bootsector/wii-retropad-adapter/board/board.png

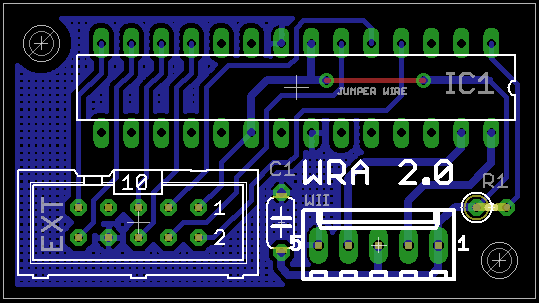
board/board.png
