bootsector/wii-retropad-adapter/board/board_v21.png

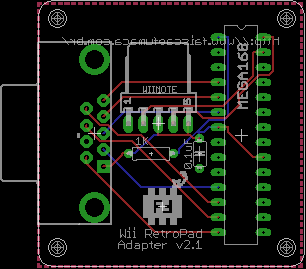
board/board_v21.png
