bootsector/wii-retropad-adapter/board/schematics_v20.png

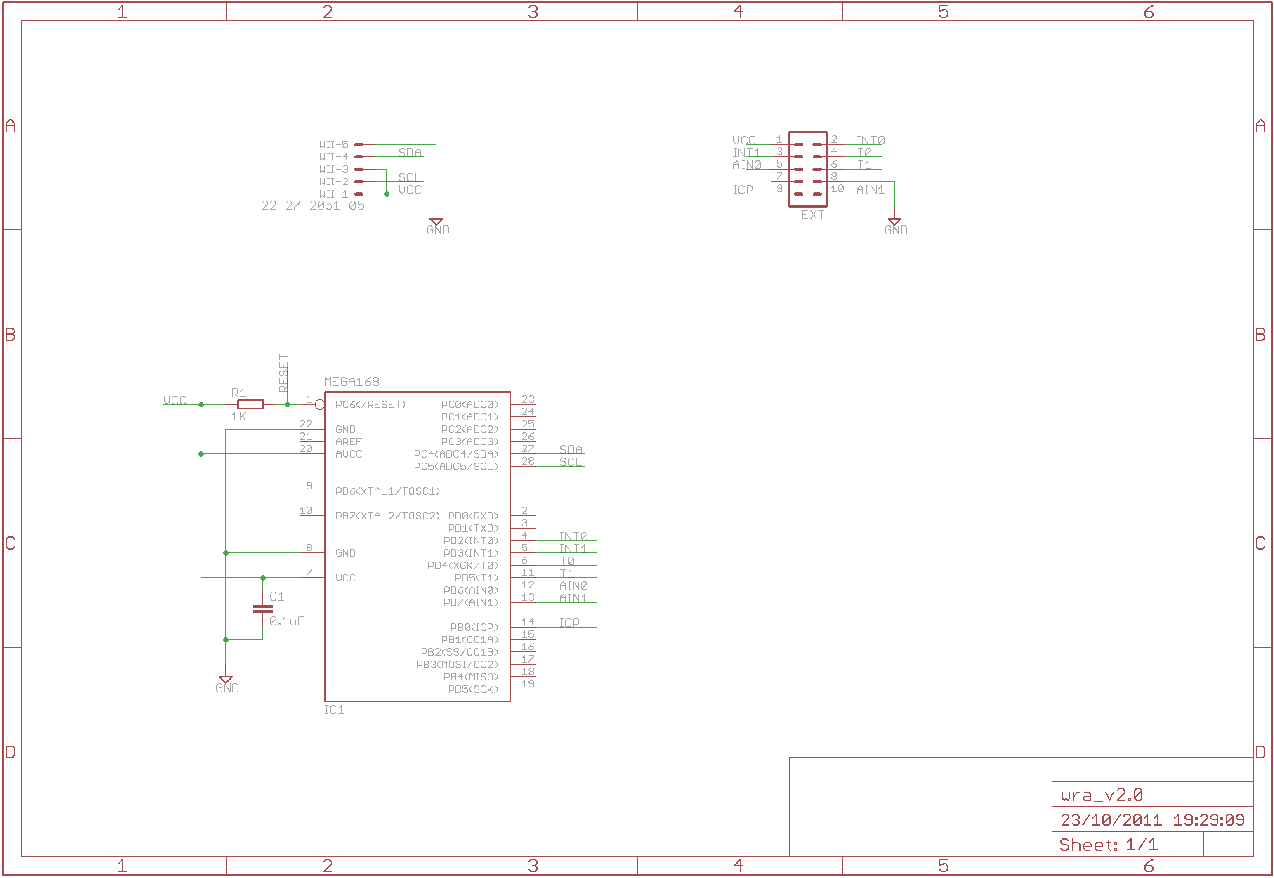
board/schematics_v20.png
