bootsector/wii-retropad-adapter/board/schematics_v21.png

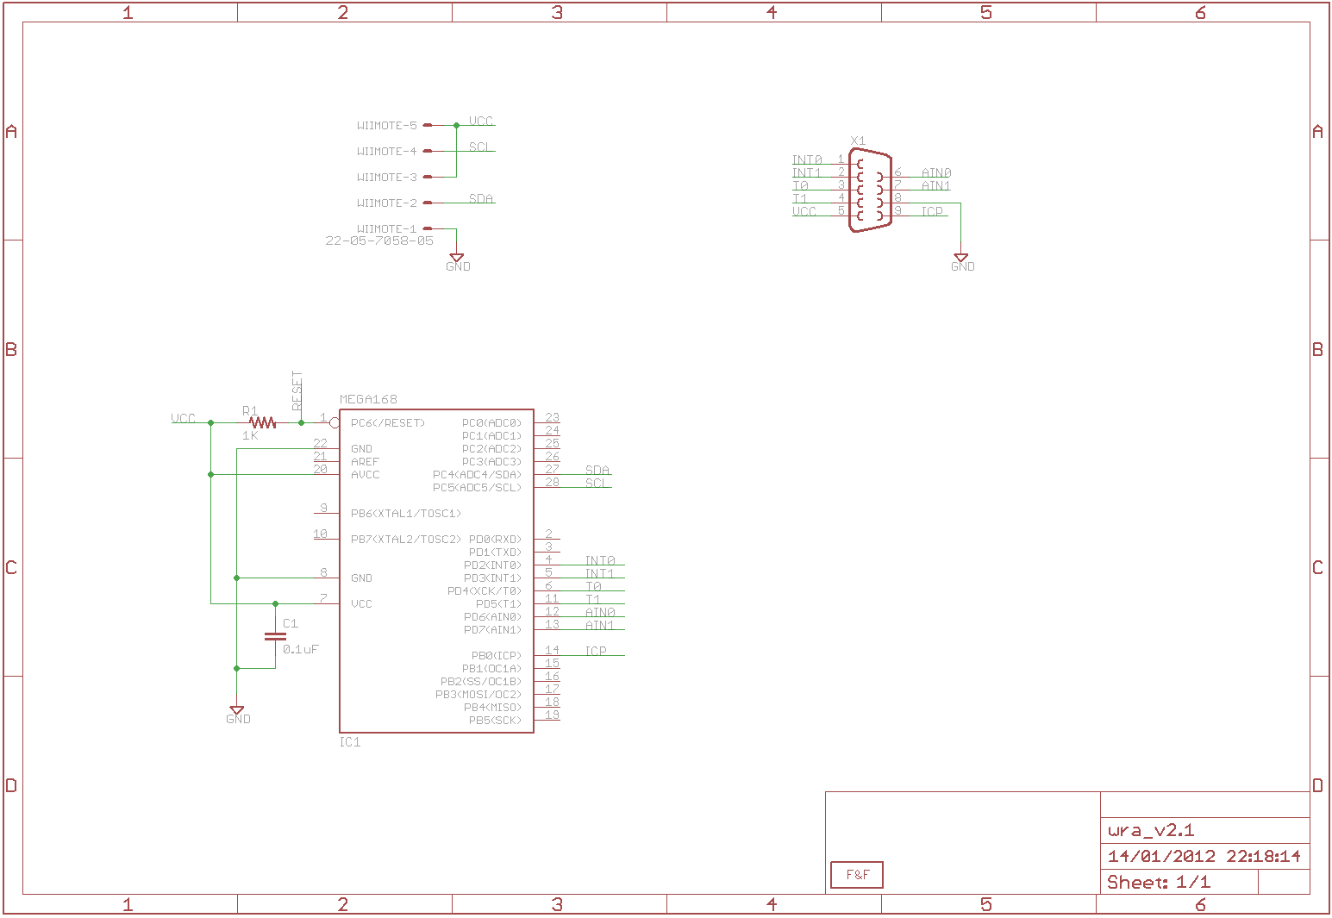
board/schematics_v21.png
