bootsector/wii-retropad-adapter/WiiRetroPadAdapterUserManual_ptBR.pdf

### Wii RetroPad Adapter 2.0 – Manual do Usuário

Rev. 2.1 – 10/03/2012

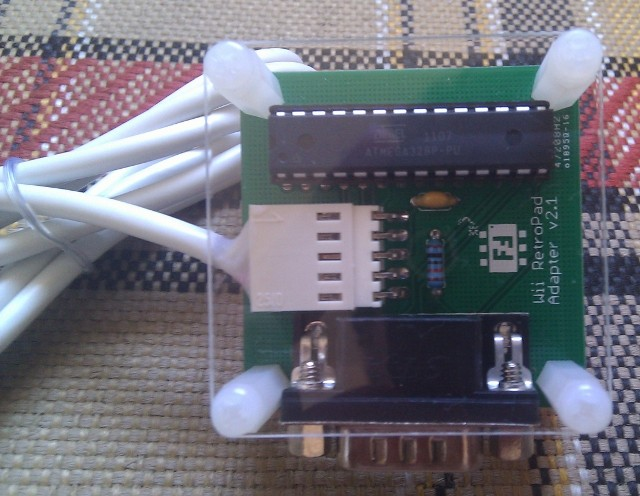
[picture p5: figure]

Conectando o adaptador ao Wiimote

- Desconecte o Wii RetroPad Adapter do Wiimote antes de conectar qualquer joystick ou cabo de expansão ao Wii

RetroPad Adapter;

- Se você for usar um joystick de Sega Genesis, Master System ou Atari 2600, conecte-o diretamente ao Wii

RetroPad Adapter, ou...

- Se você for usar qualquer outro joystick compatível com o Wii RetroPad Adapter, primeiramente conecte o cabo de

expansão (vendido separadamente) ao Wii RetroPad Adapter e então conecte o joystick ao conector do cabo de

expansão;

- Conecte o Wii RetroPad Adapter no Wiimote. Ele será reconhecido como um Classic Controller;
- Divirta-se!

Mapa de botões:

Joystick “Retrô” | Botão correspondente no Wii Classic Controller
D-Pad | Y | B | X | A | + | - | HOME | Left Analog | Right Analog | L | R | ZL | ZR
NES | D-Pad | - | B | - | A | START | SELECT | SEL.+START | - | - | - | - | - | -
Super NES | D-Pad | Y | B | X | A | START | SELECT | SEL.+START | - | - | L | R | - | -
Sega Genesis | D-Pad | A | B | Y | C | START | MODE | UP+START | - | - | X | Z | - | -
PS2 | D-Pad | [ ] | X | /\ | O | START | SELECT | SEL.+START | Left Analog | Right Analog | L1 | R1 | L2 | R2
Game Cube | D-Pad | Y | B | X | A | START | - | UP+START | Left Analog | Right Analog | L | R | Z | Z
Nintendo 64 | D-Pad | CL | B | CR | A | START | - | UP+START | Left Analog | C Buttons | L* | R | Z* | Z*

* - L e Z serão invertidos se um controle de N64 for plugado com o botão L pressionado (essa é a melhor opção para Jogos de Zelda do Nintendo 64 no Virtual Console).

Outras informações:

- Vibração do joystick não é suportado.
- Apenas Wiimotes originais são suportados e têm funcionamento garantido com esse adaptador.
- Apensar de alguns controles genéricos de PS2, Game Cube e Nintendo 64 funcionarem com esse adaptador,

apenas controles originais possuem garantia de funcionamento com esse adaptador.

- Para maiores informações, acesse: http://www.brunofreitas.com/ .
