bootsector/wii-retropad-adapter/src/wii-retropad-adapter/tg16.cpp

/*
* Wii RetroPad Adapter - Nintendo Wiimote adapter for retro-controllers!
* Copyright (c) 2011 Bruno Freitas - bruno@brunofreitas.com
*
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
* You should have received a copy of the GNU General Public License
* along with this program.  If not, see <http://www.gnu.org/licenses/>.
 */

#include "tg16.h"
#include "digitalWriteFast.h"

void tg16_init(void) {
	// Configure Data pins
	pinModeFast(2, INPUT);
	digitalWriteFast(2, HIGH);

	pinModeFast(4, INPUT);
	digitalWriteFast(4, HIGH);

	pinModeFast(5, INPUT);
	digitalWriteFast(5, HIGH);

	pinModeFast(6, INPUT);
	digitalWriteFast(6, HIGH);

	// Configure Data Select and /OE pins
	pinModeFast(7, OUTPUT);
	digitalWriteFast(7, HIGH);

	pinModeFast(8, OUTPUT);
	digitalWriteFast(8, LOW);
}

int tg16_read(void) {
	int retval = 0;

	// Data Select HIGH
	digitalWriteFast(7, HIGH);

	// /OE LOW
	digitalWriteFast(8, LOW);

	for(int i = 0; i < 2; i++) {
		// /OE LOW
		digitalWriteFast(8, LOW);
		delayMicroseconds(1);

		// If four directions are low, then it's an Avenue6 Pad
		if(!digitalReadFast(2) && !digitalReadFast(4) && !digitalReadFast(5) && !digitalReadFast(6)) {
			// Data Select LOW
			digitalWriteFast(7, LOW);
			delayMicroseconds(1);

			retval |= (!digitalReadFast(2) << 8);  // III
			retval |= (!digitalReadFast(4) << 9);  // IV
			retval |= (!digitalReadFast(5) << 10); // V
			retval |= (!digitalReadFast(6) << 11); // VI
		} else {
			// Normal pad reading
			retval |= (!digitalReadFast(2) << 0); // UP
			retval |= (!digitalReadFast(4) << 1); // RIGHT
			retval |= (!digitalReadFast(5) << 2); // DOWN
			retval |= (!digitalReadFast(6) << 3); // LEFT

			// Data Select LOW
			digitalWriteFast(7, LOW);
			delayMicroseconds(1);

			retval |= (!digitalReadFast(2) << 4); // I
			retval |= (!digitalReadFast(4) << 5); // II
			retval |= (!digitalReadFast(5) << 6); // SELECT
			retval |= (!digitalReadFast(6) << 7); // RUN
		}

		// Data Select HIGH
		digitalWriteFast(7, HIGH);

		// /OE HIGH
		digitalWriteFast(8, HIGH);
	}

	return retval;
}
