bootsector/wii-retropad-adapter/(commit log)

2011-09-20 Modified Makefile.app so it now supports programming properly. Assuming there's no Arduino bootloader on the uC (i.e., a blank atmega328p).
2011-09-25 Updated Arduino sketch. Removed old binaries folder.
2011-09-25 Updated arduinocore sources with actual arduino-22 sources.
2011-09-26 Support to WMExtension's callback for buttons update is now optional at compile time.
2011-09-27 Joystick responsiveness seems slightly improved if not using buttons update callback. Leaving it deactivated by default.
2011-09-30 Externalized compile time settings to config.h file. Home button can now be triggered by pressing UP + START (Plus) in all joysticks.
2011-10-01 Hardware changes: - All board tracks now have width of 24 mil (0.024"); - NES connector pads larger and in hexagonal format; - Generic connector changed to "6 pin KK" connector; - Wiimote connector c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
2011-10-03 Updated Arduino sketch with latest sources.
2011-10-06 Added a very simple manual for a very simple device.
2011-10-08 Fixed WMCrypt class. Now it's based on Dolphin Emu code and it's properly generating wm_ft and wm_sb tables if encryption bytes are zero.
    [WMCrypt.cpp, WMCrypt.h, WMExtension.cpp, WMExtension.h]
2011-10-15 Fixed Sega Genesis/Megadrive 3-button pad support.
    [genesis.cpp]
2011-10-15 Proper fix for Sega Genesis/Megadrive driver.
    [genesis.cpp]
2011-10-21 WRA 2.0! It will *probably* have an enclosure, but you will lose onboard support for NES, SNES and PS2 pads. It will only have a DB9 connector with native support for Sega Genesis (and compatibles) p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
2011-10-23 Added joysticks extensions schematics for WRA 2.0
2011-10-23 Updated board files for WRA 2.0.
2011-11-20 Changed HOME button combo to START + SELECT for NES, SNES and PS2 pads.
2011-11-21 :. Turned pull-up resistor for NES/SNES joypad readings ON :. Genesis 2ms delay only for 6-button joysticks :. Removed Arduino sketch folder (it can be easily converted from C sources)
2011-12-09 GC/N64 joysticks driver is ready. Support for them is coming soon...
2011-12-10 Added GC extension connection schematics.
2011-12-10 Corrected N64 button mapping. Still waiting for my N64 controller to arrive for testings...
    [wra.cpp]
2011-12-11 Uploaded N64 joystick connection schematics. Updated license inside GC/N64 driver files.
2011-12-15 Fixed silly bad copy and paste bug in N64 routine...
    [wra.cpp]
2011-12-16 N64 controller support is now fixed and tested: WORKING! :)
    [wra.cpp]
2011-12-16 N64 controller: If plugged in with L pressed, L and Z buttons will be swapped (for Zelda games' sake!)
    [wra.cpp]
2012-01-14 Added Eagle and gerber files for board version 2.1 (acrylic based "enclosure"). Also added SVG file for acrylic lasercut service.
2012-01-14 Added clearance for PCB spacers.
2012-01-15 Changed molex connector type (90o).
2012-01-15 Corrected PCB bottom silk.
2012-01-15 Changed PCB layout a little.
2012-02-08 Reverted back to Bill Porter's PSX/PS2 library until I get the correct timing for an atmega running at 8Mhz internal resonator.
    [wra.cpp]
2012-03-17 Fixed a small bug that was preventing WRA to work with third-party/knock-off Wiimotes! :)
    [WMExtension.cpp, WMExtension.h]
2012-05-10 Fixed arduino core so it compiles under newest avr-glibc versions (http://code.google.com/p/arduino/issues/detail?id=604).
2012-05-27 Added asm version of GC/N64 driver just in case future compiler versions mess with instructions (optimizations, etc...) in a way the time sensitive routines get off. Whenever that happens, use the as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
2012-06-09 Added Sega Saturn pad support (to be tested).
    DB9 pin 4 can't be used as a detection pin for Saturn pads because it
    may confuse PS2 pad detection (PS2 uses DB9 pin 4 as CLK signal).
    So, in order to get Sega Saturn pad support, you'll lose
    Sega Genesis/Master System/Atari, as Saturn pads uses almost as much
    pins from DB9 as Sega Genesis pads.
    So the default pad will be either Sega Genesis or Sega Saturn, and this
    is defined at compile time by setting the SATURN definition in the
    Makefile.
2012-06-09 :. Rewrite of the detectPad() routine so it takes care of PS2 pads/DB9 pin 4 usage. Now this should support Sega Saturn pads without losing support for Genesis pads.
    :. Dropped support for Atmega168, as firmware size is now bigger than
    16K
2012-06-10 Fixed sega saturn controller extension diagram. Also fixed/improved some stuff in the sega saturn pad reading code.
    [saturn.cpp]
2012-06-10 Changed digital pins handling functions from the "Fast" ones to the ordinary ones, as they could lead to wrong readings inside the pad detection routine.
    [wra.cpp]
2012-06-26 :. New PS2 pad driver (smaller)
    :. Re-added support to atmega168p, as the hex file got smaller with the
    new PS2 pad driver
2012-06-30 Fixed NeoGeo controller support.
    [wra.cpp]
2012-07-26 Improved PS2 pad driver
2012-07-27 PS2 pad routine doesn't disable interrupts anymore. It's probably too long and it was affecting I2C communications.
    [PS2Pad.cpp]
2012-07-27 PS2 pad driver tweak
2012-07-28 PS2 Pad driver: reverted to more aggressive interrupt disable. This makes the PS2 controller more responsive on XBOX (USB RetroPad Adapter). This can be disable so it still works on Wii RetroPad Adap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
    [PS2Pad.cpp, PS2Pad.h, wra.cpp]
2012-09-04 PS2 pad driver now detects analog mode during init.
2012-09-05 Treating Wii Classic Controller extension cable.
2012-09-29 Fixed HOME button triggering condition (Master System pad Button 2 reports like C + START buttons).
    [wra.cpp]
2012-09-30 Fixed Sega Genesis controller driver so it works fine with Sega Master System, Atari 2600 and compatibles.
    [genesis.cpp, wra.cpp]
2012-12-19 Fixed copyright line in file header for WMCrypt.cpp and WMCrypt.h (thanks marcan for letting me know!)
    [WMCrypt.cpp, WMCrypt.h]
2013-01-02 Added Wii Classic Controller and Nintendo Game Cube shoulder buttons (L and R) analog support.
2013-01-02 Halved ANALOG_NEUTRAL_RADIUS for the right analog stick since it has half of the precision of the left analog stick. Switched map() function call to a right shift operation for the GC analog shoulder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
2013-01-03 Improved GCPad driver timing by making core read/write functions inline and adjusted the delay for the reading function.
2013-01-03 Added a 6ms delay between GC pad reads so don't get the controller too much stressed. Official games poll the controller using that interval.
    [wra.cpp]
2013-01-05 Added option to disable interrupts when filling buttons data buffer for the CC emulator.
2013-01-05 Saving and restoring state of the SREG register when disabling interrupts.
2013-01-06 Fixed old IOS VC titles not detecting the Classic Controller without re-plugging.
    [WMExtension.cpp]
2013-01-09 Polling N64 and GC controllers only at every other loop cycle. This gives TWI some time to "breath" (interrupts enabled).
2013-01-10 Still trying to find the best way to prevent that interrupts being disabled by the GC and N64 pad reading routines mess with I2C/TWI comms.
    [wra.cpp]
2013-01-12 Another attempt on fixing interrupts disabling for N64 and GC controllers versus I2C communications.
    [WMExtension.cpp, WMExtension.h, twi.c, twi.h, wra.cpp]
2013-01-13 GC/N64 pad readings are now done inside the TWI ISR. Since inside ISR functions interrupts are disabled, there will be no timing issues reading the controllers. No Wire library hack is needed anymore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
    [GCPad.cpp, GCPad.h, WMExtension.cpp, WMExtension.h, twi.c, twi.h, wra.cpp]
2013-01-13 Oops! Forgot to set n64_loop_helper as the buttons callback! :P
2013-01-30 Fixed the GC/N64 pad so it doesn't wait forever during reads when controller is disconnected. That avoids the Wiimote to hang, but it still gets garbage data when plugging in the GC/N64 controller ba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
    [GCPad.cpp, GCPad.h, wra.cpp]
2013-04-21 Added TG16 extension cable schematics
2013-04-21 Fixed extension cable detection routine.
    [wra.cpp]
2013-05-02 Reverted GC and N64 code as of commit 503f52576feb7287a55d99cda62e8a10eb7c1090: N64 support was broken on commits following it.
    [GCPad.cpp, wra.cpp]
2017-02-08 Fixed support to NES Classic/Mini
    [WMExtension.cpp, WMExtension.h]
2017-03-13 Small change in the RJ45 connector footprint
2019-06-26 Fixed N64 C-buttons to right analog mappings. Improved compatibility with homebrew apps.
    [WMExtension.cpp, wra.cpp]
